iandchasse/minRead_pcb/minRead_pcb/minRead_pcb.csv

Reference | Qty | Value | DNP | Exclude from BOM | Exclude from Board | Footprint | Datasheet
C1 | 1 | 1n |  |  |  | Capacitor_SMD:C_0805_2012Metric_Pad1.18x1.45mm_HandSolder | ~
C2,C3,C10,C11,C13,C14,C15,C16,C17,C37 | 10 | 4.7u |  |  |  | Capacitor_SMD:C_0805_2012Metric_Pad1.18x1.45mm_HandSolder | ~
C4,C6,C32 | 3 | 22u |  |  |  | Capacitor_SMD:C_0805_2012Metric_Pad1.18x1.45mm_HandSolder | ~
C5,C18,C19,C20,C21,C22 | 6 | 1u |  |  |  | Capacitor_SMD:C_0805_2012Metric_Pad1.18x1.45mm_HandSolder | ~
C8,C12,C33,C36 | 4 | 0.1u |  |  |  | Capacitor_SMD:C_0805_2012Metric_Pad1.18x1.45mm_HandSolder | ~
CR1 | 1 | TSD05CDYFR |  |  |  | footprints:TVS_SOD2_DYF_TEX-M | https://www.ti.com/lit/gpn/tsd05c
D4,D5,D6 | 3 | MBR0530 |  |  |  | Diode_SMD:D_SOD-123 | http://www.mccsemi.com/up_pdf/MBR0520~MBR0580(SOD123).pdf
H1,H2,H3,H4 | 4 | MountingHole_Pad |  | Excluded from BOM |  | MountingHole:MountingHole_2.2mm_M2_DIN965_Pad_TopBottom | ~
J1 | 1 | USB_C_Receptacle |  |  |  | Connector_USB:USB_C_Receptacle_Amphenol_12401610E4-2A | https://www.usb.org/sites/default/files/documents/usb_type-c.zip
J3 | 1 | Conn_01x24 |  |  |  | custom:24pin0.5mm | ~
J5 | 1 | Conn_01x02 |  |  |  | Connector_JST:JST_PH_S2B-PH-K_1x02_P2.00mm_Horizontal | ~
J7 | 1 | Micro_SD_Card |  |  |  | Connector_Card:microSD_HC_Hirose_DM3AT-SF-PEJM5 | https://www.we-online.com/components/products/datasheet/693072010801.pdf
L1 | 1 | 68u |  |  |  | Inductor_SMD:L_Changjiang_FNR6028S | ~
Q3 | 1 | IRLML6402 |  |  |  | Package_TO_SOT_SMD:SOT-23_Handsoldering | https://www.infineon.com/dgdl/irlml6402pbf.pdf?fileId=5546d462533600a401535668d5c2263c
Q4 | 1 | Si1308EDL |  |  |  | Package_TO_SOT_SMD:SOT-323_SC-70_Handsoldering | https://www.vishay.com/docs/63399/si1308edl.pdf
Q5 | 1 | AO3401A |  |  |  | Package_TO_SOT_SMD:SOT-23_Handsoldering | http://www.aosmd.com/pdfs/datasheet/AO3401A.pdf
Q6 | 1 | SS8050 |  |  |  | Package_TO_SOT_SMD:SOT-23 | http://www.secosgmbh.com/datasheet/products/SSMPTransistor/SOT-23/SS8050.pdf
R1 | 1 | 1M |  |  |  | Resistor_SMD:R_0805_2012Metric_Pad1.20x1.40mm_HandSolder | ~
R2,R3 | 2 | 5.1k |  |  |  | Resistor_SMD:R_0805_2012Metric_Pad1.20x1.40mm_HandSolder | ~
R4,R11,R28 | 3 | 1.1k |  |  |  | Resistor_SMD:R_0805_2012Metric_Pad1.20x1.40mm_HandSolder | ~
R5 | 1 | 8.9k |  |  |  | Resistor_SMD:R_0805_2012Metric_Pad1.20x1.40mm_HandSolder | ~
R6,R7,R8,R9,R13,R15,R17,R53,R54,R55 | 10 | 10k |  |  |  | Resistor_SMD:R_0805_2012Metric_Pad1.20x1.40mm_HandSolder | ~
R10,R18,R19,R20 | 4 | 47k |  |  |  | Resistor_SMD:R_0805_2012Metric_Pad1.20x1.40mm_HandSolder | ~
R12 | 1 | 100k |  |  |  | Resistor_SMD:R_0805_2012Metric_Pad1.20x1.40mm_HandSolder | ~
R14 | 1 | 3 |  |  |  | Resistor_SMD:R_0805_2012Metric_Pad1.20x1.40mm_HandSolder | ~
R16 | 1 | 1k |  |  |  | Resistor_SMD:R_0805_2012Metric_Pad1.20x1.40mm_HandSolder | ~
R21,R22,R23,R24,R25,R26,R29,R30,R31,R32,R33,R34 | 12 | 33 |  |  |  | Resistor_SMD:R_0805_2012Metric_Pad1.20x1.40mm_HandSolder | ~
R27 | 1 | 0 |  |  |  | Resistor_SMD:R_0603_1608Metric_Pad0.98x0.95mm_HandSolder | ~
SW1,SW4,SW5,SW7 | 4 | SW_Push |  |  |  | Button_Switch_THT:SW_Tactile_SPST_Angled_PTS645Vx39-2LFS | ~
SW2,SW3,SW6,SW12 | 4 | SW_Push |  |  |  | Button_Switch_SMD:SW_SPST_PTS810 | ~
U1,U5 | 2 | TPD4E004DRYR |  |  |  | TPD4E004DRYR:PSON50P145X100X60-6N
U2 | 1 | BQ24074RGT |  |  |  | Package_DFN_QFN:VQFN-16-1EP_3x3mm_P0.5mm_EP1.6x1.6mm | http://www.ti.com/lit/ds/symlink/bq24074.pdf
U3 | 1 | AP2112K-3.3 |  |  |  | Package_TO_SOT_SMD:SOT-23-5_HandSoldering | https://www.diodes.com/assets/Datasheets/AP2112.pdf
U4 | 1 | ESP32-S3-WROOM-1 |  |  |  | RF_Module:ESP32-S3-WROOM-1 | https://www.espressif.com/sites/default/files/documentation/esp32-s3-wroom-1_wroom-1u_datasheet_en.pdf
