iandchasse/minRead_pcb/minRead_pcb/minRead_pcb.kicad_pcb

## KiCad design minRead_pcb/minRead_pcb.kicad_pcb (2026-01-22)

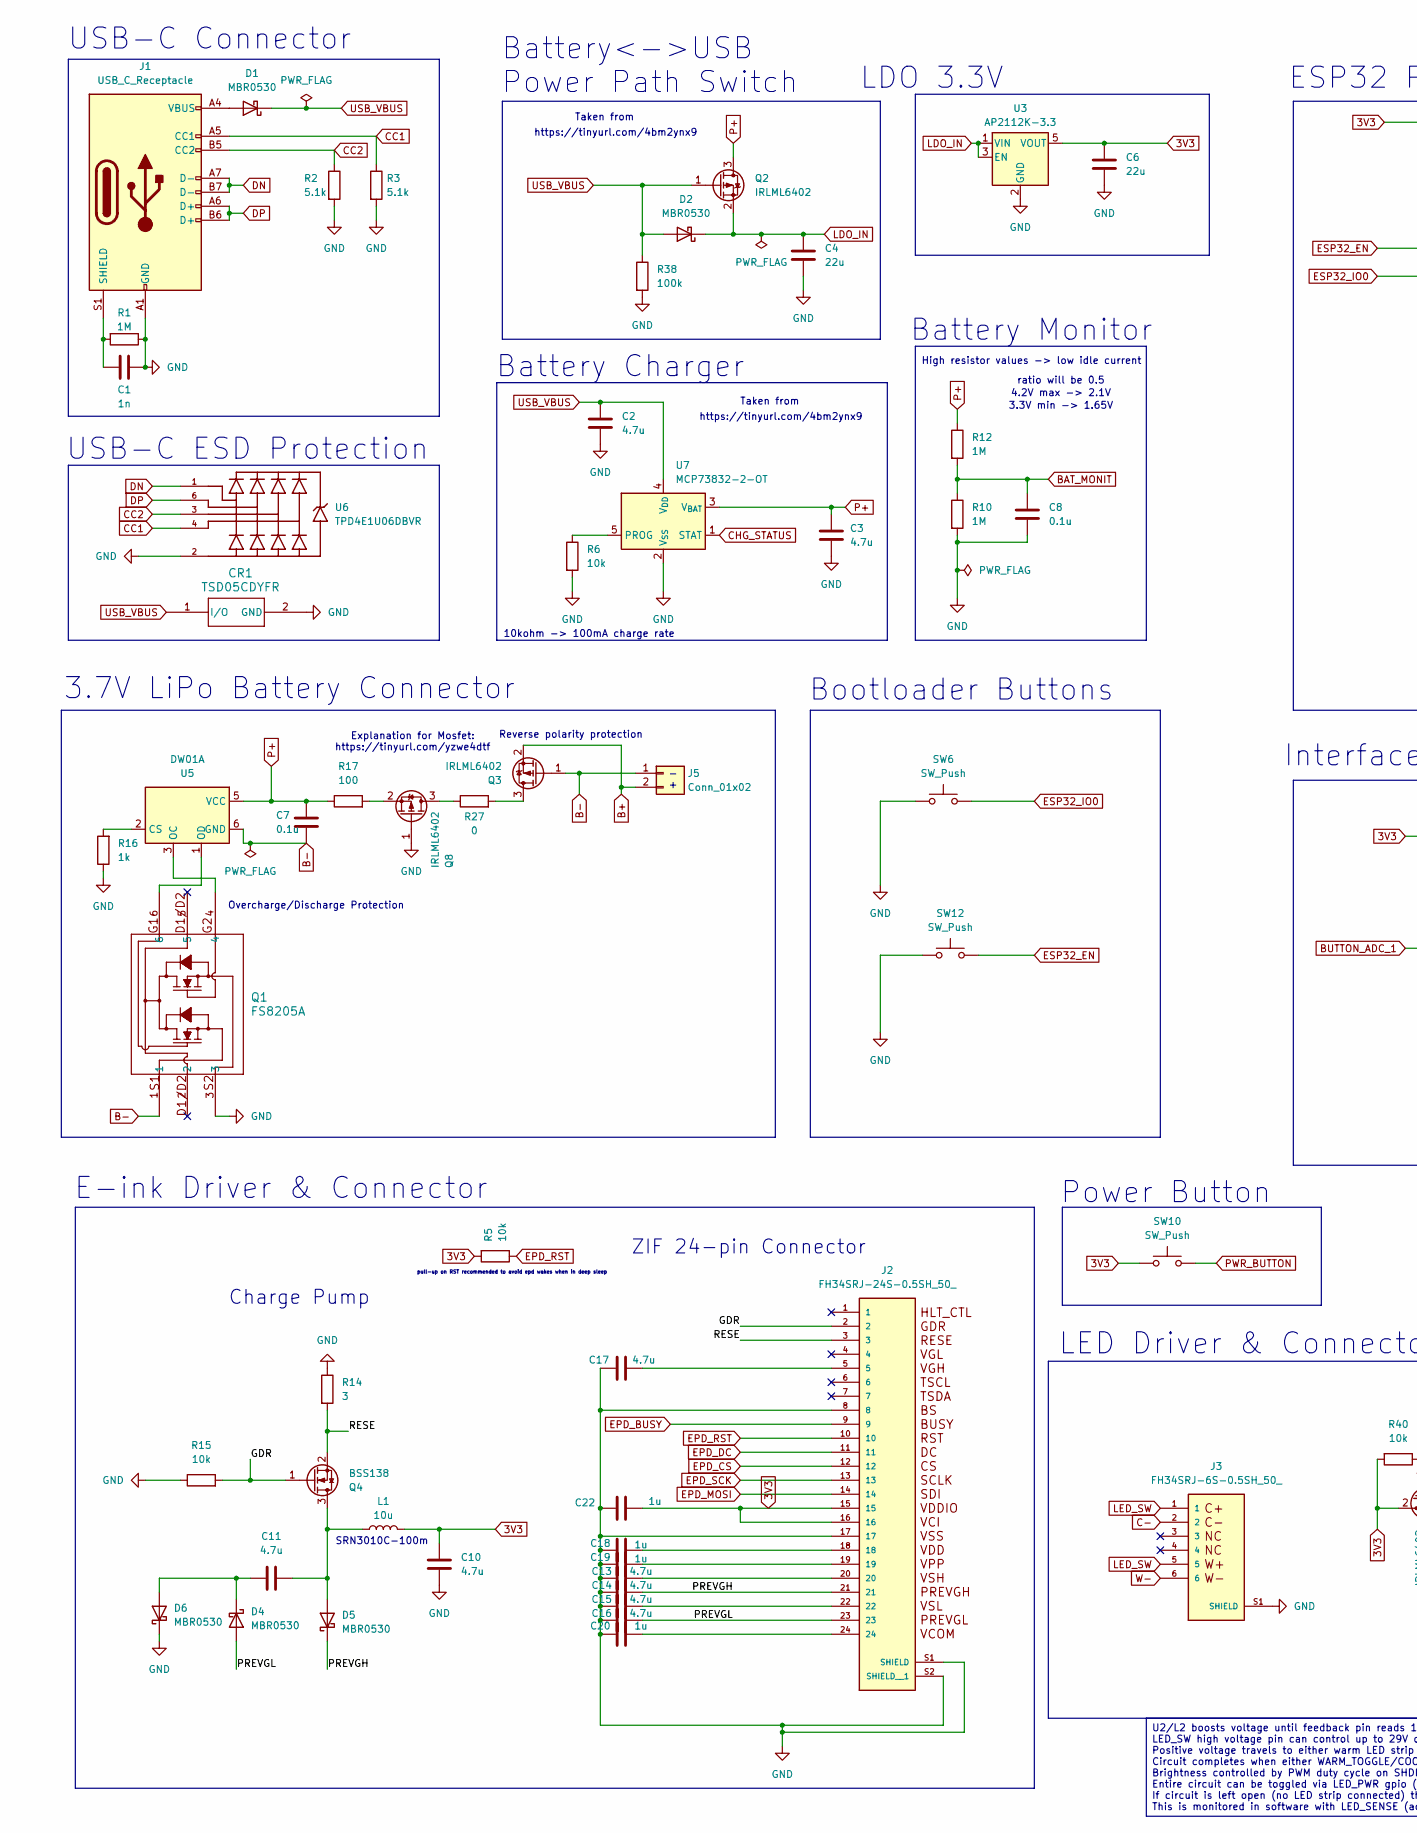
[picture p1: schematic minRead_pcb.kicad_sch, part in row 1, column 1]

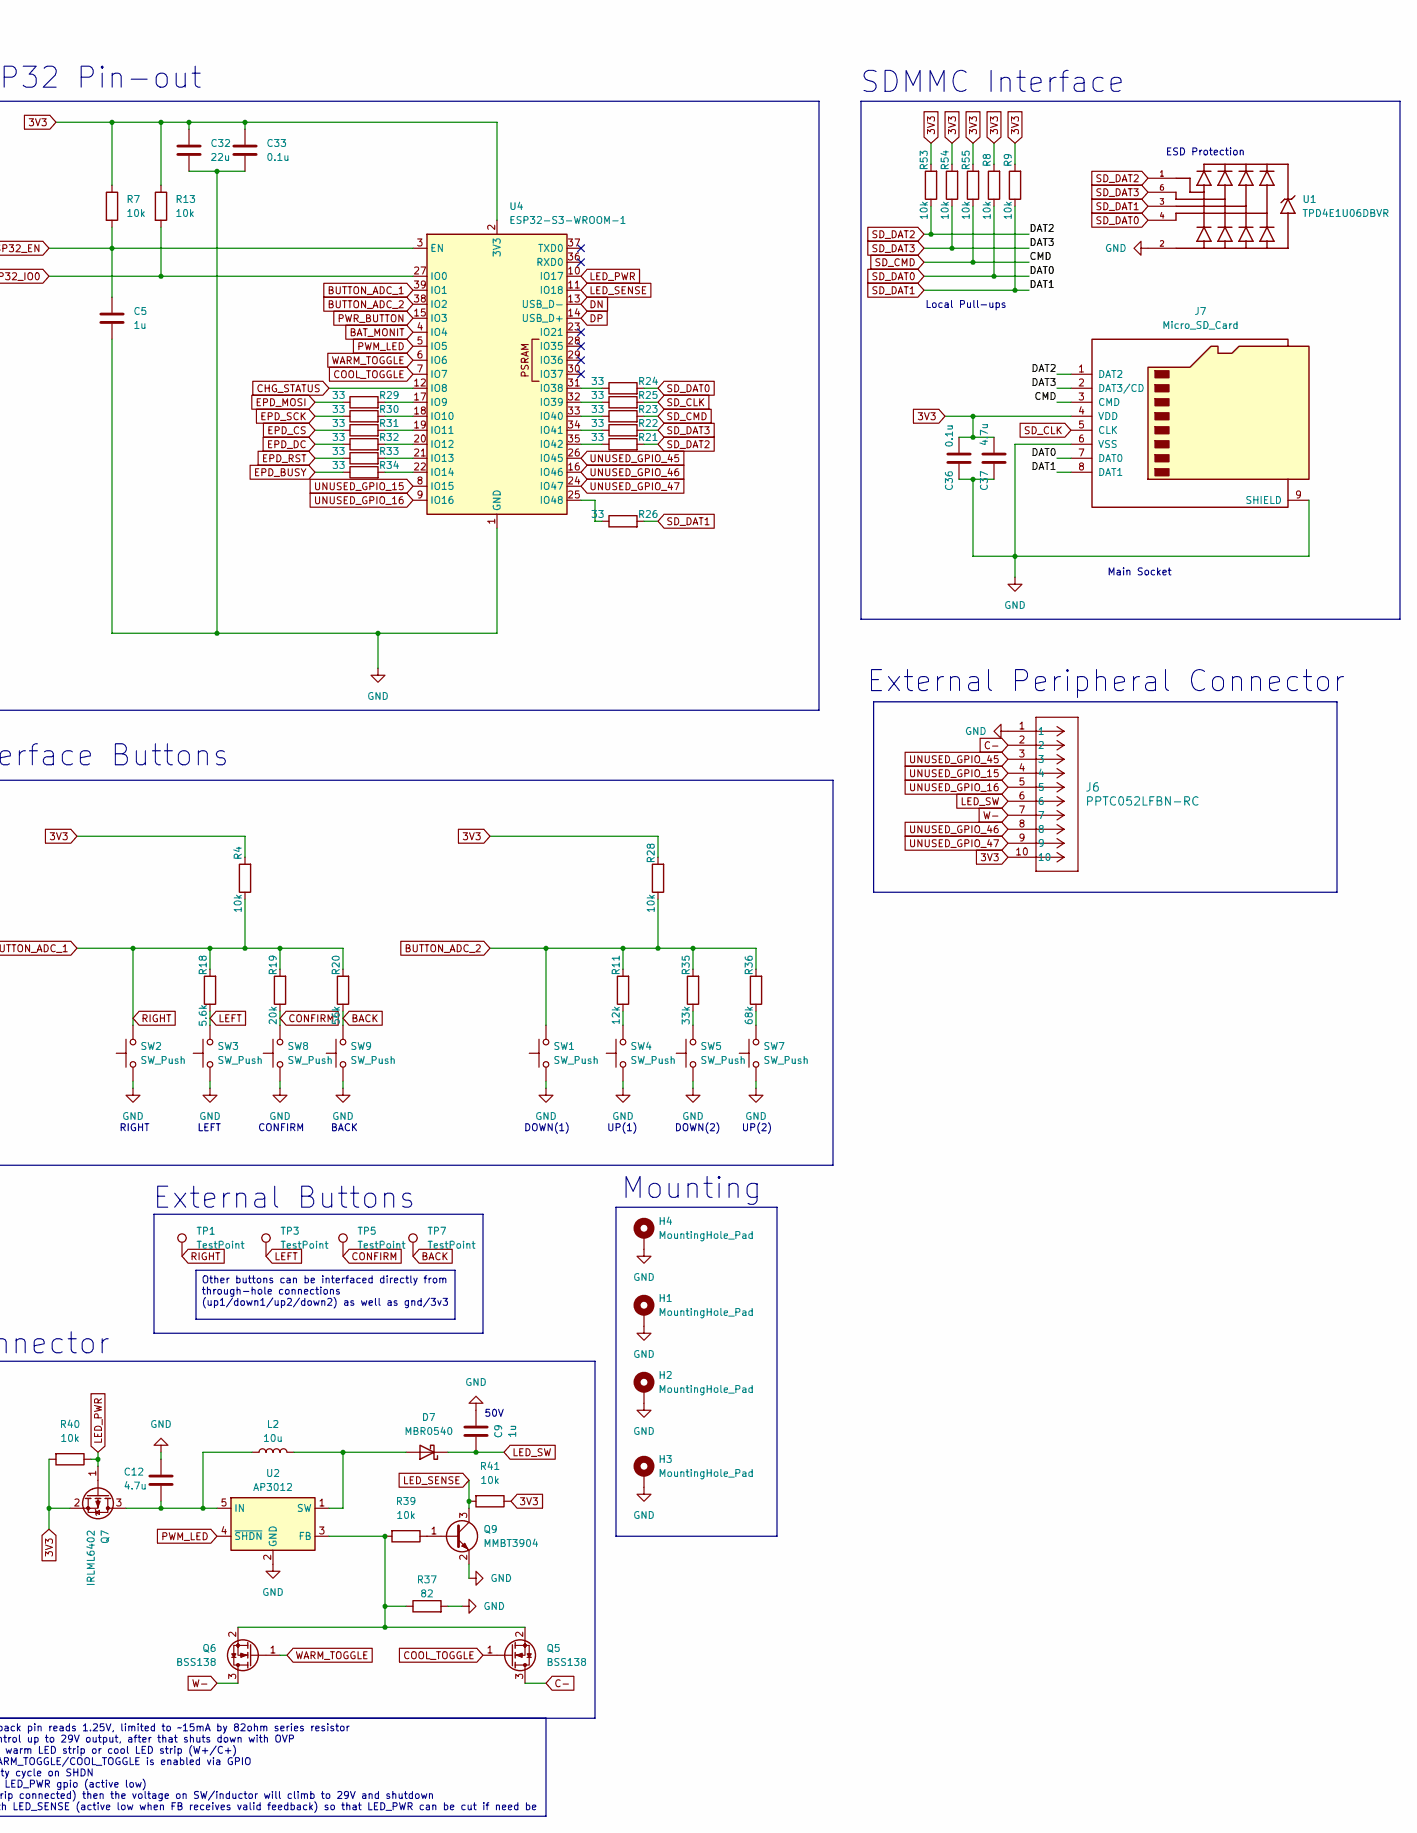
[picture p2: schematic minRead_pcb.kicad_sch, part in row 1, column 2]

Parts:
C1: 1n; C_0805_2012Metric_Pad1.18x1.45mm_HandSolder
C2, C3, C10, C11, C12, C13, C14, C15, C16, C17, C37: 4.7u; C_0805_2012Metric_Pad1.18x1.45mm_HandSolder
C4, C6, C32: 22u; C_0805_2012Metric_Pad1.18x1.45mm_HandSolder
C5, C9, C18, C19, C20, C22: 1u; C_0805_2012Metric_Pad1.18x1.45mm_HandSolder
C7, C8, C33, C36: 0.1u; C_0805_2012Metric_Pad1.18x1.45mm_HandSolder
CR1: TSD05CDYFR; TVS_SOD2_DYF_TEX-M
D1, D2, D4, D5, D6: MBR0530; D_SOD-123
D7: MBR0540; D_SOD-123
H1, H2, H3, H4: MountingHole_Pad; MountingHole_2.2mm_M2_DIN965_Pad_TopBottom
J1: USB_C_Receptacle; USB_C_Receptacle_GCT_USB4085
J2: FH34SRJ-24S-0.5SH_50_; HRS_FH34SRJ-24S-0.5SH_50_
J3: FH34SRJ-6S-0.5SH_50_; HRS_FH34SRJ-6S-0.5SH_50_; DigiKey_Part_Number H125773CT-ND
J5: Conn_01x02; JST_PH_S2B-PH-K_1x02_P2.00mm_Horizontal
J6: PPTC052LFBN-RC; CONN_PPTC052LFBN-RC_SUL
J7: Micro_SD_Card; microSD_HC_Hirose_DM3AT-SF-PEJM5
L1, L2: 10u; IND_SRN3010C-100M
Q1: FS8205A; SOT-23-6_Handsoldering
Q2, Q3, Q7, Q8: IRLML6402; SOT-23_Handsoldering
Q4, Q5, Q6: BSS138; SOT-23
Q9: MMBT3904; SOT-23_Handsoldering
R1, R10, R12: 1M; R_0805_2012Metric_Pad1.20x1.40mm_HandSolder
R2, R3: 5.1k; R_0805_2012Metric_Pad1.20x1.40mm_HandSolder
R4, R5, R6, R7, R8, R9, R13, R15, R28, R39, R40, R41, R53, R54, R55: 10k; R_0805_2012Metric_Pad1.20x1.40mm_HandSolder
R11: 12k; R_0805_2012Metric_Pad1.20x1.40mm_HandSolder
R14: 3; R_0805_2012Metric_Pad1.20x1.40mm_HandSolder
R16: 1k; R_0805_2012Metric_Pad1.20x1.40mm_HandSolder
R17: 100; R_0805_2012Metric_Pad1.20x1.40mm_HandSolder
R18: 5.6k; R_0805_2012Metric_Pad1.20x1.40mm_HandSolder
R19: 20k; R_0805_2012Metric_Pad1.20x1.40mm_HandSolder
R20: 56k; R_0805_2012Metric_Pad1.20x1.40mm_HandSolder
R21, R22, R23, R24, R25, R26, R29, R30, R31, R32, R33, R34: 33; R_0805_2012Metric_Pad1.20x1.40mm_HandSolder
R27: 0; R_0805_2012Metric_Pad1.20x1.40mm_HandSolder
R35: 33k; R_0805_2012Metric_Pad1.20x1.40mm_HandSolder
R36: 68k; R_0805_2012Metric_Pad1.20x1.40mm_HandSolder
R37: 82; R_0805_2012Metric_Pad1.20x1.40mm_HandSolder
R38: 100k; R_0805_2012Metric_Pad1.20x1.40mm_HandSolder
SW1, SW4, SW5, SW7, SW10: SW_Push; SW_Tactile_SPST_Angled_PTS645Vx39-2LFS
SW2, SW3, SW6, SW8, SW9, SW12: SW_Push; SW_SPST_PTS810
TP1, TP3, TP5, TP7: TestPoint; TestPoint_THTPad_1.0x1.0mm_Drill0.5mm
U1, U6: TPD4E1U06DBVR; SOT-23-6_Handsoldering; PARTREV D; DigiKey_Part_Number 296-35965-1-ND
U2: AP3012; SOT-23-5
U3: AP2112K-3.3; SOT-23-5_HandSoldering
U4: ESP32-S3-WROOM-1
U5: DW01A; SOT-23-6_Handsoldering
U7: MCP73832-2-OT; SOT-23-5

Connections:
3V3: C6.1, C10.2, C22.2, C32.1, C33.1, C36.2, C37.2, J2.15, J2.16, J6.10, J7.4 (VDD), L1.2, Q7.2 (S), R4.2, R5.2, R7.1, R8.2, R9.2, R13.1, R28.2, R40.2, R41.1, R53.2, R54.2, R55.2, SW10.1, U3.5 (VOUT), U4.2 (3V3)
/GDR: J2.2, Q4.1 (G), R15.2
/PREVGH: C14.2, D5.1 (K), J2.21
/PREVGL: C16.2, D4.2 (A), J2.23
/RESE: J2.3, Q4.2 (S), R14.2
B+: J5.2, Q3.2 (S)
B-: C7.2, J5.1, Q1.1, Q3.1 (G), U5.6 (GND)
BACK: R20.1, SW9.2, TP7.1
BAT_MONIT: C8.1, R10.1, R12.2, U4.4 (IO4)
BUTTON_ADC_1: R4.1, R18.2, R19.2, R20.2, SW2.2, TP1.1, U4.39 (IO1)
BUTTON_ADC_2: R11.2, R28.1, R35.2, R36.2, SW1.2, U4.38 (IO2)
C-: J3.2, J6.2, Q5.3 (D)
CC1: J1.A5 (CC1), R3.1, U6.4
CC2: J1.B5 (CC2), R2.1, U6.3
CHG_STATUS: U4.12 (IO8), U7.1 (STAT)
CONFIRM: R19.1, SW8.2, TP5.1
COOL_TOGGLE: Q5.1 (G), U4.7 (IO7)
DN: J1.A7 (D-), J1.B7 (D-), U4.13 (USB_D-), U6.1
DP: J1.A6 (D+), J1.B6 (D+), U4.14 (USB_D+), U6.6
EPD_BUSY: J2.9, R34.1
EPD_CS: J2.12, R31.1
EPD_DC: J2.11, R32.1
EPD_MOSI: J2.14, R29.1
EPD_RST: J2.10, R5.1, R33.1
EPD_SCK: J2.13, R30.1
ESP32_EN: C5.1, R7.2, SW12.2, U4.3 (EN)
ESP32_IO0: R13.2, SW6.2, U4.27 (IO0)
GND: C1.1, C2.2, C3.2, C4.2, C5.2, C6.2, C8.2, C9.1, C10.1, C12.1, C13.1, C14.1, C15.1, C16.1, C17.1, C18.1, C19.1, C20.1, C22.1, C32.2, C33.2, C36.1, C37.1, CR1.2 (GND), D6.1 (K), H1.1, H2.1, H3.1, H4.1, J1.A1 (GND), J1.A12 (GND), J1.B1 (GND), J1.B12 (GND), J2.8, J2.17, J2.S1 (SHIELD), J2.S2 (SHIELD__1), J3.S1 (SHIELD), J3.S2 (SHIELD), J6.1, J7.6 (VSS), J7.9 (SHIELD), Q1.3, Q8.1 (G), Q9.2 (E), R1.1, R2.2, R3.2, R6.2, R10.2, R14.1, R15.1, R16.1, R37.2, R38.2, SW1.1, SW2.1, SW3.1, SW4.1, SW5.1, SW6.1, SW7.1, SW8.1, SW9.1, SW12.1, U1.2, U2.2 (GND), U3.2 (GND), U4.1 (GND), U4.40 (GND), U4.41 (GND), U6.2, U7.2 (V_{SS})
LDO_IN: C4.1, D2.1 (K), Q2.2 (S), U3.1 (VIN), U3.3 (EN)
LED_PWR: Q7.1 (G), R40.1, U4.10 (IO17)
LED_SENSE: Q9.3 (C), R41.2, U4.11 (IO18)
LED_SW: C9.2, D7.1 (K), J3.1, J3.5, J6.6
LEFT: R18.1, SW3.2, TP3.1
unnamed: C13.2, J2.20
unnamed: C15.2, J2.22
unnamed: C17.2, J2.5
unnamed: C18.2, J2.18
unnamed: C19.2, J2.19
unnamed: C20.2, J2.24
unnamed: D1.2 (A), J1.A4 (VBUS), J1.A9 (VBUS), J1.B4 (VBUS), J1.B9 (VBUS)
unnamed: C11.1, D4.1 (K), D6.2 (A)
unnamed: C11.2, D5.2 (A), L1.1, Q4.3 (D)
unnamed: D7.2 (A), L2.2, U2.1 (SW)
unnamed: C1.2, J1.S1 (SHIELD), R1.2
unnamed: Q3.3 (D), R27.2
unnamed: Q5.2 (S), Q6.2 (S), R37.1, R39.2, U2.3 (FB)
unnamed: C12.2, L2.1, Q7.3 (D), U2.5 (IN)
unnamed: Q8.3 (D), R27.1
unnamed: Q8.2 (S), R17.2
unnamed: Q9.1 (B), R39.1
unnamed: R11.1, SW4.2
unnamed: R35.1, SW5.2
unnamed: R36.1, SW7.2
unnamed: R29.2, U4.17 (IO9)
unnamed: R30.2, U4.18 (IO10)
unnamed: R31.2, U4.19 (IO11)
unnamed: R32.2, U4.20 (IO12)
unnamed: R33.2, U4.21 (IO13)
unnamed: R34.2, U4.22 (IO14)
unnamed: R24.1, U4.31 (IO38)
unnamed: R25.1, U4.32 (IO39)
unnamed: R23.1, U4.33 (IO40)
unnamed: R22.1, U4.34 (IO41)
unnamed: R21.1, U4.35 (IO42)
unnamed: R26.1, U4.25 (IO48)
unnamed: R16.2, U5.2 (CS)
unnamed: Q1.4, U5.3 (OC)
unnamed: Q1.6, U5.1 (OD)
unnamed: R6.1, U7.5 (PROG)
P+: C3.1, C7.1, Q2.3 (D), R12.1, R17.1, U5.5 (VCC), U7.3 (V_{BAT})
PWM_LED: U2.4 (~SHDN), U4.5 (IO5)
PWR_BUTTON: SW10.2, U4.15 (IO3)
SD_CLK: J7.5 (CLK), R25.2
SD_CMD: J7.3 (CMD), R23.2, R55.1
SD_DAT0: J7.7 (DAT0), R8.1, R24.2, U1.4
SD_DAT1: J7.8 (DAT1), R9.1, R26.2, U1.3
SD_DAT2: J7.1 (DAT2), R21.2, R53.1, U1.1
SD_DAT3: J7.2 (DAT3/CD), R22.2, R54.1, U1.6
UNUSED_GPIO_15: J6.4, U4.8 (IO15)
UNUSED_GPIO_16: J6.5, U4.9 (IO16)
UNUSED_GPIO_45: J6.3, U4.26 (IO45)
UNUSED_GPIO_46: J6.8, U4.16 (IO46)
UNUSED_GPIO_47: J6.9, U4.24 (IO47)
USB_VBUS: C2.1, CR1.1 (I/O), D1.1 (K), D2.2 (A), Q2.1 (G), R38.1, U7.4 (V_{DD})
W-: J3.6, J6.7, Q6.3 (D)
WARM_TOGGLE: Q6.1 (G), U4.6 (IO6)

Notes on the sheet:
Overcharge/Discharge Protection
ratio will be 0.5
SDMMC Interface
Battery<->USB Power Path Switch
RIGHT LEFT CONFIRM BACK
3.7V LiPo Battery Connector
Charge Pump
LED Driver & Connector
SRN3010C-100m
Interface Buttons
3.3V min -> 1.65V
- +
Taken from
pull-up on RST recommended to avoid epd wakes when in deep sleep
50V
External Peripheral Connector
E-ink Driver & Connector
ESD Protection
Battery Charger
ESP32 Pin-out
https://tinyurl.com/4bm2ynx9
Reverse polarity protection
4.2V max -> 2.1V
ZIF 24-pin Connector
Local Pull-ups
DOWN(1) UP(1) DOWN(2) UP(2)
LDO 3.3V
Power Button
High resistor values -> low idle current
Battery Monitor
Explanation for Mosfet:
USB-C ESD Protection
USB-C Connector
Bootloader Buttons
External Buttons
Mounting
10kohm -> 100mA charge rate
Main Socket
https://tinyurl.com/yzwe4dtf
Other buttons can be interfaced directly from through-hole connections (up1/down1/up2/down2) as well as gnd/3v3
U2/L2 boosts voltage until feedback pin reads 1.25V, limited to ~15mA by 82ohm series resistor LED_SW high voltage pin can control up to 29V output, after that shuts down with OVP Positive voltage travels to either warm LED strip or cool LED strip (W+/C+) Circuit completes when either WARM_TOGGLE/C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

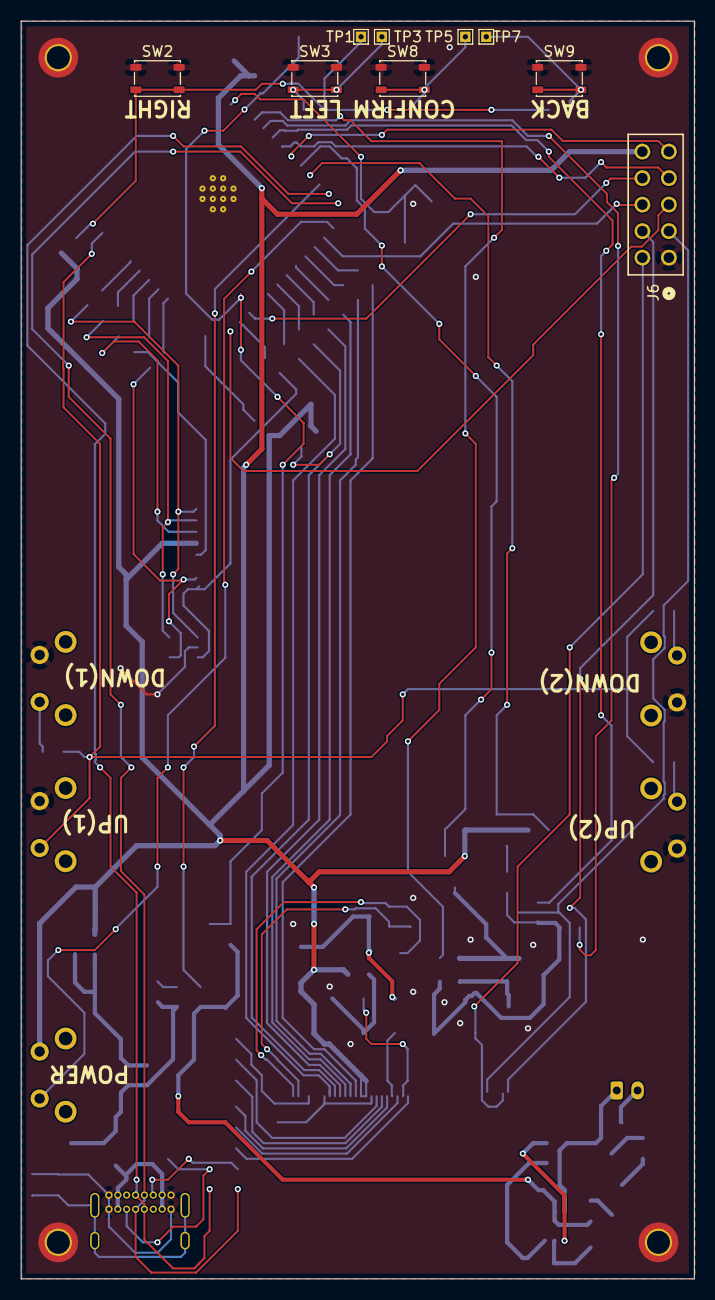
[picture p3: board minRead_pcb.kicad_pcb from above]

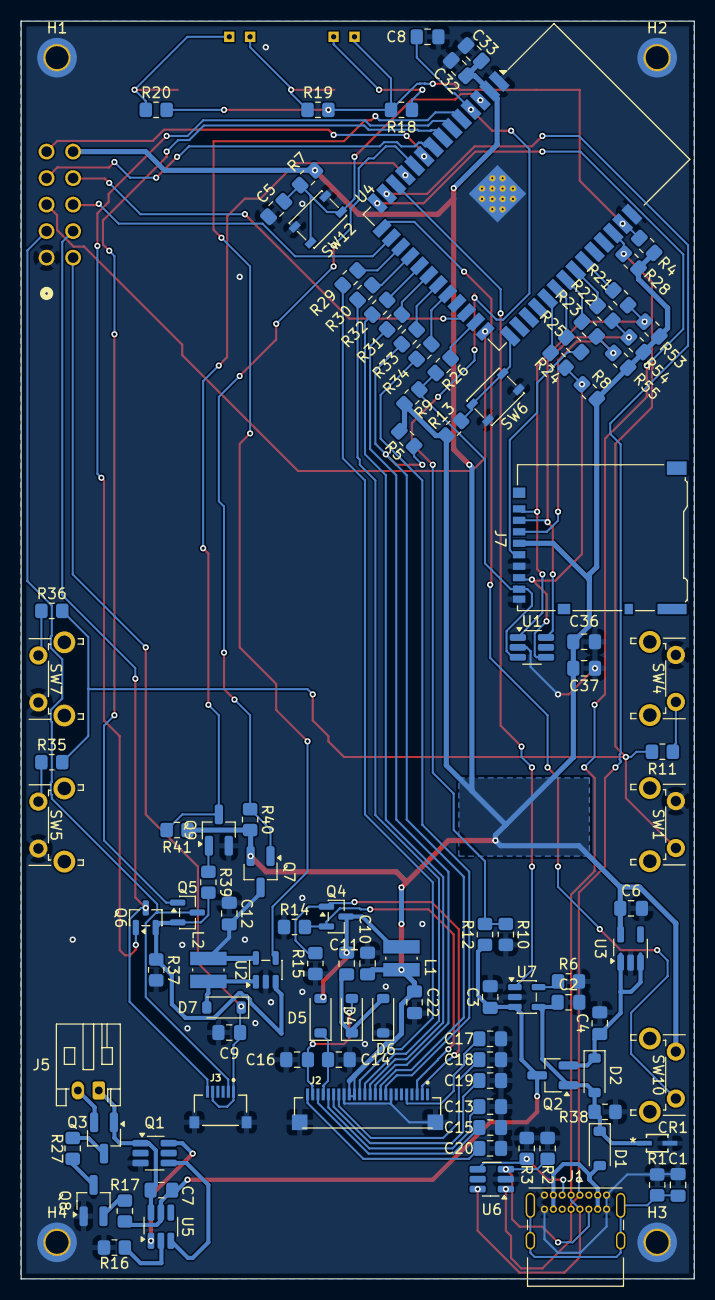
[picture p4: board minRead_pcb.kicad_pcb from below]

Board: 2 copper layers, 64.5 x 120.5 mm, 119 parts (110 on the bottom side), 86 nets.
