iandchasse/minRead_pcb/(commit log)

2025-12-13 first pcb revision : shit - needs to revise bq24074 current limit (usb500 mode?) - double check jst battery polarity - need to adjust caps for e-ink driver - double check usb polarity - q4 orientatio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
    [BOM-EPD_HUB_ESP32.csv, ESP32.kicad_sch, E_ink_HAT.kicad_sch, LED_control.kicad_sch, LiPo_In.kicad_sch, MicroSD_Out.kicad_sch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]
2025-12-17 - schematic updates: - usb500 mode enabled on bq - charge limit set to 100mA 8.9kohm (safe for small batteries) - series resistors on sd card and epd lines - esd arrays for usb-c and sd-card - increa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
    new layout:
    - adjusted board size
    - very compact
    - need to fill ground planes and check drc errors (a lot because of solder mask)
    - need to adjust jst footprint in case there's a better choice
    - review review review
    [E_ink_HAT.kicad_sch, LiPo_In.kicad_sch, buttons.kicad_sch, esp32_s3.kicad_sch, minRead_pcb.kicad_pcb, minRead_pcb.kicad_sch, untitled.kicad_sch, usbc_power_native.kicad_sch]
2025-12-18 draft new rev compact as possible confirmed reverse polarity circuit but need to double check jst connector made sure buttons were as evenly spaced as possible need to ensure every cap is 25v toleran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
    [esp32_s3.kicad_sch, minRead_pcb.kicad_pcb]
2026-01-14 - fixed diode orientation of eink booster - everything works except eink driver: - rst pin pulls high, dc doesn't toggle, etc etc. - TODO for next rev: - remove reset stabilizer and just route 3v3 to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
    [BOM-EPD_HUB_ESP32.csv, E_ink_HAT.kicad_sch, LiPo_In.kicad_sch, esp32_s3.kicad_sch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]
2026-01-20 gigantic commit, my bad revised schematic to sanity check turns out my fpc was flipped, now fixed added following schematics: - battery protection circuit - series LED driver - external peripheral co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
    New layout:
    - mostly same as last time, but work done to ensure good grounding for LED/eink circuits
    - eink gpio has minimal crossing/coupl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
    [E_ink_HAT.kicad_sch, LiPo_In.kicad_sch, buttons.kicad_sch, esp32_s3.kicad_sch, minRead_pcb.kicad_pcb, minRead_pcb.kicad_sch, untitled.kicad_sch, usbc_power_native.kicad_sch]
2026-01-22 updated some things: - confirmed battery protection circuit - added pull up to EPD_RST - changed to 10 pin external IO header instead of 12 pin - reserved gpio 17 and 18 for LED_PWR and LED_SENSE - r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
    [minRead_pcb.kicad_pcb, minRead_pcb.kicad_sch]
